thurst42g/iFROST-/impedance transformer prototype/IMG_1435.JPG

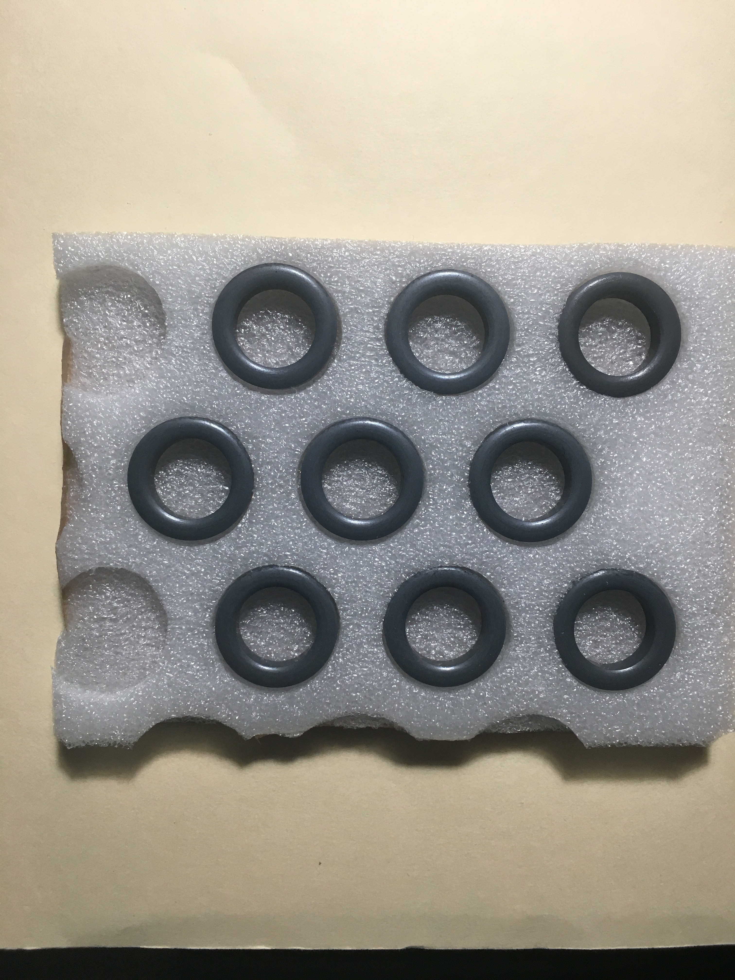
impedance transformer prototype/IMG_1435.JPG
