thurst42g/iFROST-/impedance transformer prototype/1212-04.jpg

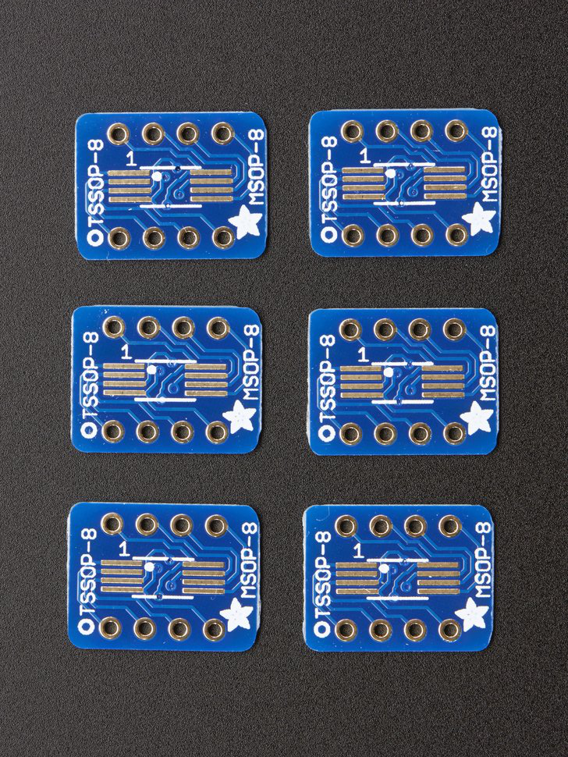
impedance transformer prototype/1212-04.jpg
