thurst42g/iFROST-/impedance transformer prototype/breakdown.PNG

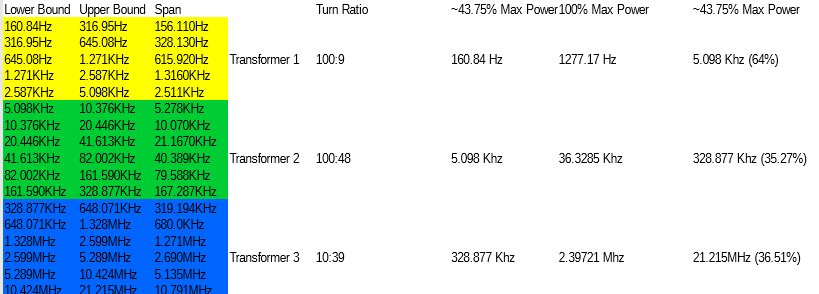
impedance transformer prototype/breakdown.PNG
