thurst42g/iFROST-/impedance transformer prototype/IMG_1436.JPG

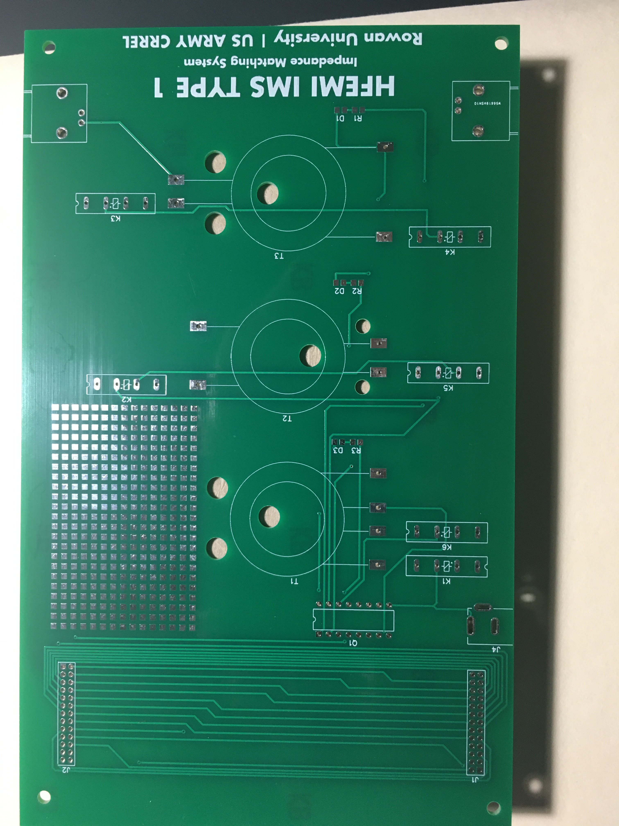
impedance transformer prototype/IMG_1436.JPG
