thurst42g/iFROST-/impedance transformer prototype/IMG_1437.JPG

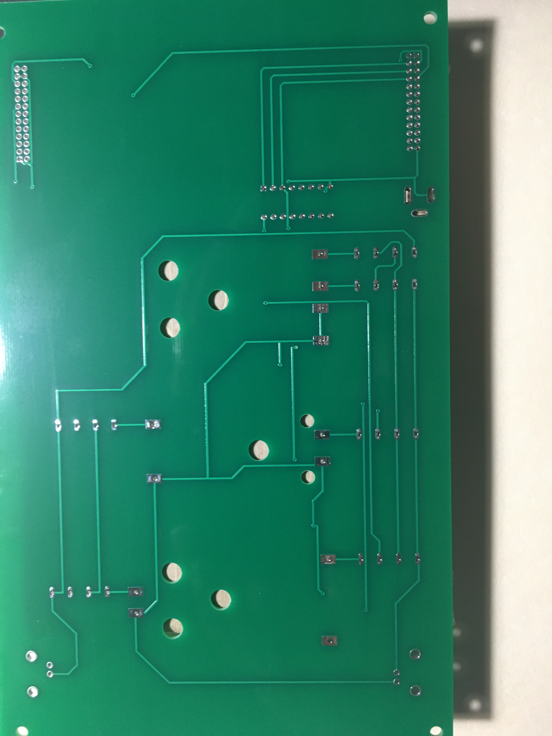
impedance transformer prototype/IMG_1437.JPG
