thurst42g/iFROST-/LOCKIN/Scope Data/Image 0.png

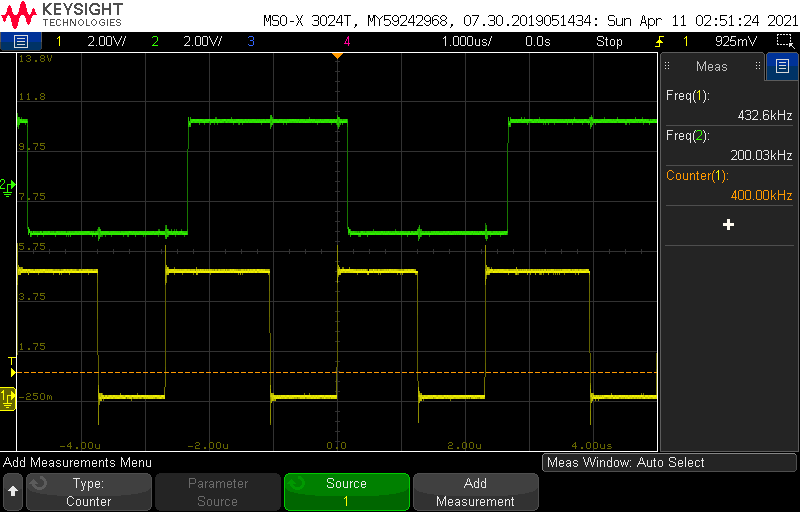
LOCKIN/Scope Data/Image 0.png
