thurst42g/iFROST-/LOCKIN/Scope Data/Image 1.png

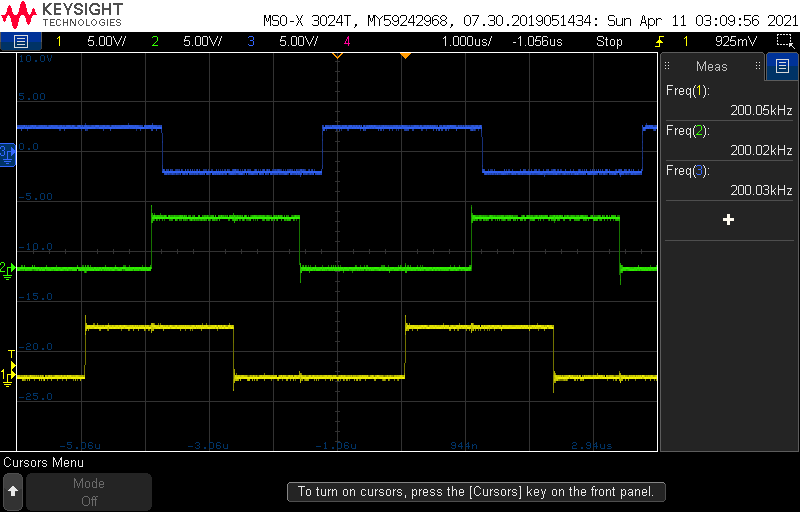
LOCKIN/Scope Data/Image 1.png
