thurst42g/iFROST-/impedance transformer prototype/Elec BOM.ods

SHOPPING CART
This is not an invoice
09-Sep-20 11:58:46
 | Mouser # | Mfr. # | Manufacturer | Customer # | Description | RoHS | Lifecycle | Order Qty. | Price (USD) | Ext.: (USD)
1
2
3
4
5
6
7
8 | 511-ULN2003A | ULN2003A | STMicroelectronics |  | Darlington Transistors Seven NPN Array | RoHS Compliant |  | 5 | $0.51 | $2.55
9 | 755-SML-H12U8TT86C | SML-H12U8TT86C | ROHM Semiconductor |  | Standard LEDs - SMD Red 620nm 40mcd 2.2V; 20mA 0805 | RoHS Compliant |  | 20 | $0.283 | $5.66
10 | 934-HE3621A1250 | HE3621A1250 | Littelfuse |  | Reed Relays REED RELAY | RoHS Compliant |  | 10 | $1.79 | $17.90
11 | 490-PJ-002A | PJ-002A | CUI Devices |  | DC Power Connectors Power Jacks | RoHS Compliant |  | 5 | $0.59 | $2.95
12 | 517-4816-3000-CP | 4816-3000-CP | 3M |  | IC & Component Sockets 16P DUAL WIPE DIPSKT | RoHS Compliant |  | 2 | $0.53 | $1.06
13 | 649-76385-313LF | 76385-313LF | FCI / Amphenol |  | Headers & Wire Housings 26P VERT DR HDR AU | RoHS Compliant |  | 3 | $2.34 | $7.02
14 | 523-31-5637 | 031-5637 | Amphenol |  | RF Connectors / Coaxial Connectors RIGHT ANGLE PCB JACK | RoHS Compliant By Exemption |  | 4 | $5.18 | $20.72
15 | 71-CRCW0805-50 | CRCW080550R0FKTA | Vishay |  | Thick Film Resistors - SMD 1/8watt 50ohms 1% Non Std Qt Req'd | No |  | 50 | $0.279 | $13.95
16 | 534-4946 | 4946 | Keystone Electronics |  | Standoffs & Spacers M/F NYLON STANDOFF 4-40 1.00 L | RoHS Compliant |  | 10 | $0.566 | $5.66
17 | 534-9605 | 9605 | Keystone Electronics |  | Screws & Fasteners 1/4 4-40 Nylon Hex M SCREW NUT | RoHS Compliant |  | 11 | $0.124 | $1.36
By submitting your order you agree to these terms and conditions. (https://www.mouser.com/saleterms) |  |  |  |  |  |  |  |  | Merchandise Total: | $475.05
Prices are reflected at the date and time shown. |  |  |  |  |  |  |  |  | Shipping Charge: | $11.59
