thurst42g/iFROST-/Partial Lab Instrument/INTERFACE/BOM.csv

RefDes | Value | Name
D1 |  | LED
D2 |  | LED
J3 |  | 644456-3
J4 |  | 90131-0152
R1 | 490 | RES_0805
R2 | 490 | RES_0805
