thurst42g/iFROST-/Partial Lab Instrument/Cart_Jan19_1144AM.xls

SHOPPING CART
This is not an invoice
19-Jan-21 11:44:20
 | Mouser # | Mfr. # | Manufacturer | Customer # | Description | RoHS | Lifecycle | Order Qty. | Price (USD) | Ext.: (USD)
1 | 855-M20-6102045 | M20-6102045 | Harwin |  | PC / 104 Connectors PC104 STACK CONNECT 20+20 HI TEMP AU |  |  | 8 | $4.99 | $39.92
2 | 855-M20-6112045 | M20-6112045 | Harwin |  | PC / 104 Connectors 20+20P NON-STACK 2.54MM DIL | RoHS Compliant |  | 4 | $4.46 | $17.84
3 | 523-112640 | 112640 | Amphenol |  | RF Connectors / Coaxial Connectors BNC PCB END LAUNCH 50 OHM RND BODY | RoHS Compliant By Exemption |  | 25 | $5.54 | $138.50
4 | 595-THS4631D | THS4631D | Texas Instruments |  | High Speed Operational Amplifiers High Speed FET-Input Op Amp | RoHS Compliant |  | 10 | $5.91 | $59.10
5 | 571-214376675 | 4DB-P108-03 | TE Connectivity |  | Barrier Terminal Blocks DUAL VERT FLAT 3P | RoHS Compliant |  | 10 | $0.891 | $8.91
6 | 755-SML-H12U8TT86C | SML-H12U8TT86C | ROHM Semiconductor |  | Standard LEDs - SMD Red 620nm 40mcd 2.2V; 20mA 0805 | RoHS Compliant |  | 20 | $0.283 | $5.66
7 | 534-PC104-AL | PC104-AL | Keystone Electronics |  | Standoffs & Spacers PC 104 MOUNTING KIT ALUMINUM | RoHS Compliant |  | 5 | $4.68 | $23.40
8 | 810-C2012X7R1E335K | C2012X7R1E335K125AB | TDK |  | Multilayer Ceramic Capacitors MLCC - SMD/SMT 0805 25V 3.3uF X7R 10% T: 1.25mm | RoHS Compliant |  | 30 | $0.231 | $6.93
9 | 992-BNC-F-TERM-S | BNC-F-TERM-S | Gravitech |  | Terminal Block Interface Modules BNC Screw terminal Breakout Board-Fem |  | New Product | 12 | $2.75 | $33.00
By submitting your order you agree to these terms and conditions. (https://www.mouser.com/saleterms) |  |  |  |  |  |  |  |  | Merchandise: | $333.26
Prices are reflected at the date and time shown. |  |  |  |  |  |  |  |  | Shipping Charge: | $10.69
