thurst42g/iFROST-/Partial Lab Instrument/TX/BOM.csv

RefDes | Value | Name
C3 | 2.5u | CAP_0805
C4 |  | CAP_0805
C13 | 100p | CAP_0805
C14 | 3.3uF | CAP_0805
C22 | 0.1uF | CAP_0805
C23 | 3.3uF | CAP_0805
C24 | 0.1uF | CAP_0805
J1 |  | 1566230
J3 |  | 1566230
J4 |  | 90131-0152
J5 |  | 1566230
R5 | 450 | RES_0805
R8 | About 47 | RES_2010
R11 | 50 | RES_0805
R12 | 1.47k | RES_0805
U3 |  | AMPLIFIER
