thurst42g/iFROST-/AMP TYPEVI/BOMPeak.csv

RefDes | Value | Name
C1 | 3.3uF | CAP_0805
C2 | 0.1uF | CAP_0805
C3 | 3.3uF | CAP_0805
C4 | 0.1uF | CAP_0805
C5 |  | CAP_0805
C15 | 3.3uF | CAP_0805
C16 | 0.1uF | CAP_0805
C17 | 3.3uF | CAP_0805
C18 | 0.1uF | CAP_0805
D1 |  | 1N4148
D2 |  | 1N4148
J1 |  | 132203
J2 |  | 132203
J5 |  | 788782-2
K1 |  | 35701331
R1 | 10k | RES
R2 | 10k | RES
U1 |  | AMPLIFIER
U2 |  | AMPLIFIER
U3 |  | ULN2003AID
