thurst42g/iFROST-/impedance transformer prototype/Board Landing Patterns/Transformer3.dxf

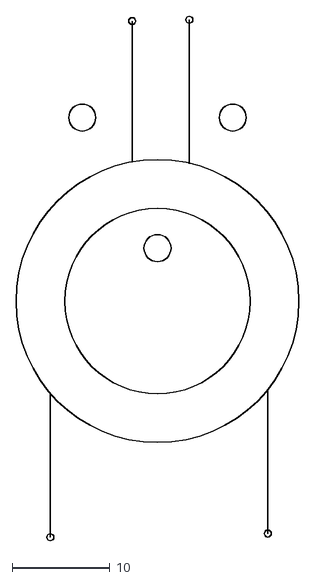
[picture p37: CAD file, 2021-07-01]
impedance transformer prototype/Board Landing Patterns/Transformer3.dxf
29.0 x 53.8
