thurst42g/iFROST-/impedance transformer prototype/Board Landing Patterns/Transformer1.dxf

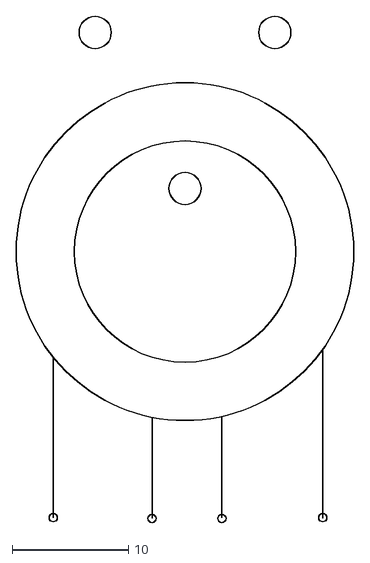
[picture p38: CAD file, 2021-07-01]
impedance transformer prototype/Board Landing Patterns/Transformer1.dxf
29.0 x 43.5
