thurst42g/iFROST-/impedance transformer prototype/Board Landing Patterns/Transformer2.dxf

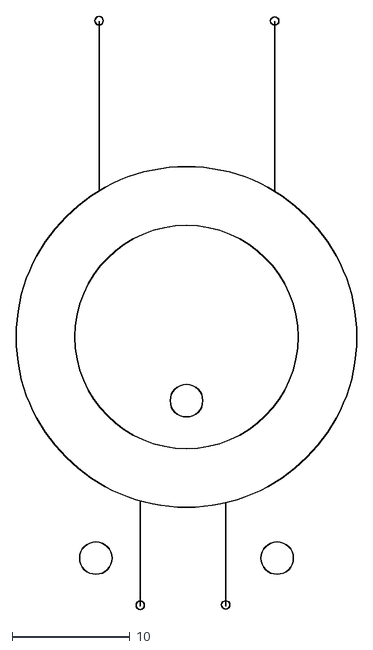
[picture p39: CAD file, 2021-07-01]
impedance transformer prototype/Board Landing Patterns/Transformer2.dxf
29.0 x 50.5
