thurst42g/iFROST-/Partial Lab Instrument/112640.stp

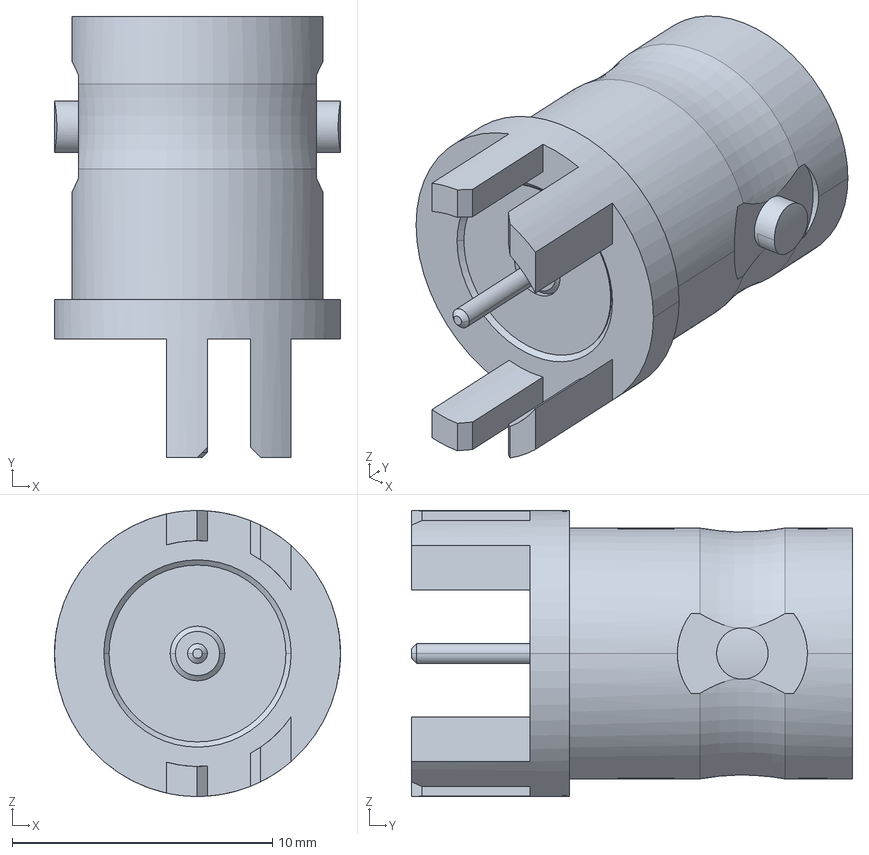
[picture p40: CAD file, 2021-07-01]
Partial Lab Instrument/112640.stp
11.0 x 17.0 x 11.0 mm
