thurst42g/iFROST-/(list of files, cad)

Other CAD files:
impedance transformer prototype/test diagram2.dwg
impedance transformer prototype/core design.dwg
impedance transformer prototype/test diagram.dwg
impedance transformer prototype/Drawing1.dwg
