thurst42g/iFROST-/impedance transformer prototype/boardtop.pdf

HFEMI IMS TYPE 1

Impedance Matching System

Rowan University | US ARMY CRREL
