thurst42g/iFROST-/(list of files, drawings)

Other design files:
AMP TYPEVI/AMP.dch
AMP TYPEVI/PCB.dip
AMP TYPEVI/PCB_PEAK.dip
AMP TYPEVI/peak.dch
data acc/SCH.dch
LOCKIN/BOARD.dip
LOCKIN/LockIn.dch
Partial Lab Instrument/INTERFACE/INTERFACE.dch
Partial Lab Instrument/INTERFACE/INTERFACE.dip
Partial Lab Instrument/RX/board.dip
Partial Lab Instrument/RX/RX.dch
Partial Lab Instrument/TX/TX.dch
Partial Lab Instrument/TX/TX.dip
